Rujul-Rumale/OpenVCU/README.md

<div align="center">

# OpenVCU

### Open Vehicle Control Unit — one board, every vehicle.

**Quad · Plane · Rover · Boat — configurable STM32H7 controller for anything that moves.**






*Open hardware. Designed from scratch. Built to be flashed for whatever you bolt it to.*

</div>

---

## What is this?

OpenVCU is an **open-source vehicle control unit** built around the **STM32H743VIT6** (480&nbsp;MHz Cortex-M7, 2&nbsp;MB flash, 1&nbsp;MB RAM).

Off-the-shelf F4 flight controllers run out of headroom when you fuse RTK GPS + IMU at high rates for EKF-heavy work like 3D photogrammetry surveys. OpenVCU is my answer: H7-class compute, a clean sensor set, and one PCB that can be configured as a **quad, fixed-wing, rover, or boat** controller.

> ⚠️ **WIP — schematic in progress.** The schematic is done and under review; **layout hasn't started** and nothing has been manufactured. Firmware lives out-of-tree for now and is intentionally **not in this repo**.

---

## One board, four vehicles

| Vehicle | What OpenVCU gives you |
| :--- | :--- |
| 🚁 **Quad** | 4× PWM motor outputs (TIM1), 6-axis IMU + baro, SD logging |
| ✈️ **Plane** | PWM for elevon / tail / throttle + UART GPS + I2C compass header |
| 🚗 **Rover** | PWM for steering + throttle, battery sensing, FRAM for params |
| 🚤 **Boat** | Same as rover + sealed-box-friendly USB-C + SD blackbox |

All vehicle personalities share the same core: **IMU → EKF → PWM + telemetry + log**. The difference is just configuration and wiring.

---

## Hardware at a glance

| Block | Part | Notes |
| :--- | :--- | :--- |
| MCU | **STM32H743VIT6** | 480&nbsp;MHz M7, LQFP-100, 8&nbsp;MHz HSE + 32.768&nbsp;kHz LSE |
| IMU | **ICM-42688-P** | 6-axis, SPI, 32&nbsp;kHz ODR |
| Baro | **DPS310** | I2C `0x76`, interrupt pin routed |
| Logging | **FM25V02A** FRAM 256&nbsp;KB (SPI) + **microSD** over SDMMC1 4-bit | Params + blackbox |
| Power | LiPo → **MP1584EN** buck (5&nbsp;V) → **AP2112K** 3.3&nbsp;V LDO | Fused + reverse-protected input |
| USB | **USB-C** + USBLC6-2SC6 ESD | 5.1&nbsp;kΩ CC pull-downs |
| Compass | External via I2C header | For real heading on rovers / boats / planes |

---

## Interfaces

### PWM motor / servo outputs

| Output | MCU pin | Timer |
| :--- | :--- | :--- |
| OUT 1 | PE9 | TIM1_CH1 |
| OUT 2 | PE11 | TIM1_CH2 |
| OUT 3 | PE13 | TIM1_CH3 |
| OUT 4 | PE14 | TIM1_CH4 |

Quads take all four. Planes / rovers / boats just remap them (e.g. steering + throttle).

### Comms & storage

| Bus | Use |
| :--- | :--- |
| UART1 / UART3 / UART6 | GPS, telemetry radio, RC |
| I2C1 / I2C2 | Onboard DPS310 + external compass |
| SPI1 | ICM-42688-P |
| SPI2 / SPI3 | Expansion + FM25V02A FRAM |
| SDMMC1 | microSD 4-bit |
| USB OTG_FS | USB-C (PA11/PA12) |

### SWD debug header

| Pin | Signal |
| :--- | :--- |
| 1 | +3V3 |
| 2 | SWDIO (PA13) |
| 3 | SWCLK (PA14) |
| 4 | GND |

Flash with ST-Link + STM32CubeProgrammer once firmware lands.

---

## Repo structure

```
OpenVCU/
├── PCB/          # KiCad 10 — schematics + project libs (layout stays local)
│   ├── OpenVCU.kicad_sch      # root sheet
│   ├── Power.kicad_sch
│   ├── Sensors.kicad_sch
│   ├── Peripherals.kicad_sch
│   ├── OpenVCU.kicad_sym      # project symbols
│   └── OpenVCU.pretty/        # project footprints
├── bom/          # BOM CSV + interactive BOM
├── docs/
│   └── datasheets/            # vendor datasheets for every key part
├── LICENSE          # CERN-OHL-S-2.0 — hardware (PCB/, bom/)
├── LICENSE-MIT      # MIT — docs/, everything else
├── CONTRIBUTING.md
└── README.md
```

> Only schematics + libraries live in git. Layout (`.kicad_pcb`), gerbers, and firmware are **deliberately excluded** for now — layout is still WIP, firmware lands as `Firmware/` once the board is validated.

---

## Status & roadmap

- ✅ Schematic complete (hierarchical: Power / Sensors / Peripherals)
- ✅ BOM + interactive BOM exported
- 🚧 **Layout in progress** — not in git yet, no gerbers, nothing ordered
- ⏳ **Finish layout → DRC → manufacture rev A**
- ⏳ Bring-up: power rails → SWD → IMU/baro probe → SD + FRAM
- ⏳ Firmware bring-up (out-of-tree until hardware is proven)
- ⏳ Vehicle configs: quad → plane → rover → boat

---

## Getting started

### 1. Open the hardware

```bash
git clone https://github.com/<you>/OpenVCU.git
cd OpenVCU
# open PCB/OpenVCU.kicad_pro in KiCad 10
```

You need **KiCad 10** (project symbols live in `OpenVCU.kicad_sym`, footprints in `OpenVCU.pretty/`).

### 2. Review the BOM

- `bom/bom.csv` — orderable line items
- `bom/ibom.html` — interactive BOM, open in a browser

### 3. Layout / manufacturing

Layout is still WIP and lives only locally — there are no gerbers in this repo yet. Once the layout lands, re-export gerbers from the layout before ordering.

---

## Design notes

- **VCAP1/VCAP2 need exactly 2.2&nbsp;µF ceramic** or the H7 internal LDO goes unstable.
- **USB-C CC pins need 5.1&nbsp;kΩ to GND** or chargers won't enumerate the board.
- Planned stackup: 4-layer with GND pour; crystal section gets an isolated GND island.

---

## Contributing

WIP hardware — reviews welcome, especially on power, crystal, and sensor routing. See [CONTRIBUTING.md](CONTRIBUTING.md).

---

## ⚠️ Caution

Nothing here has touched real copper yet. Double-check every pin against the schematic before you fab or flash, and expect rev-A debugging.

---

## License

- **Hardware** (`PCB/`, `bom/`) — [CERN-OHL-S-2.0](LICENSE). If you make or sell boards from this design or a modified version, share your modified design files under the same license.
- **Docs, everything else** — [MIT](LICENSE-MIT).

---

## Credits

- Designed by **Rujul**
- [KiCad](https://www.kicad.org/) for schematic design
- Datasheets in `docs/datasheets/` belong to their respective vendors
