Rujul-Rumale/OpenVCU/PCB/OpenVCU.kicad_pcb

## KiCad design PCB/OpenVCU.kicad_pcb (2026-10-03)

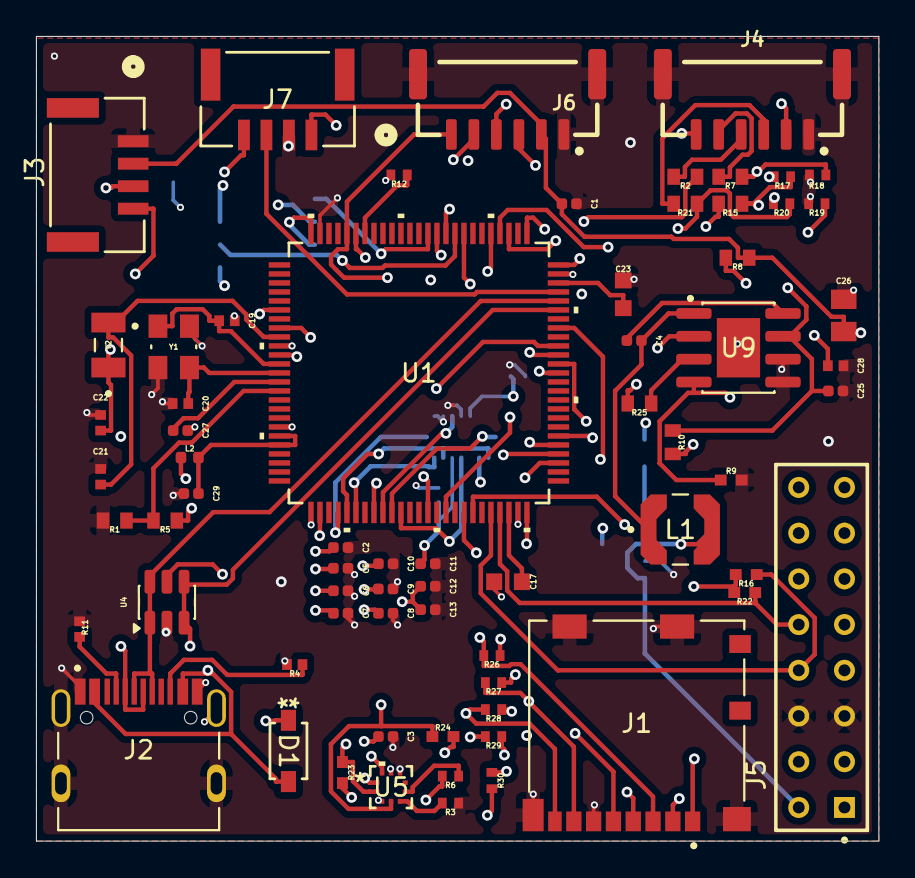
[picture p1: board OpenVCU.kicad_pcb from above]

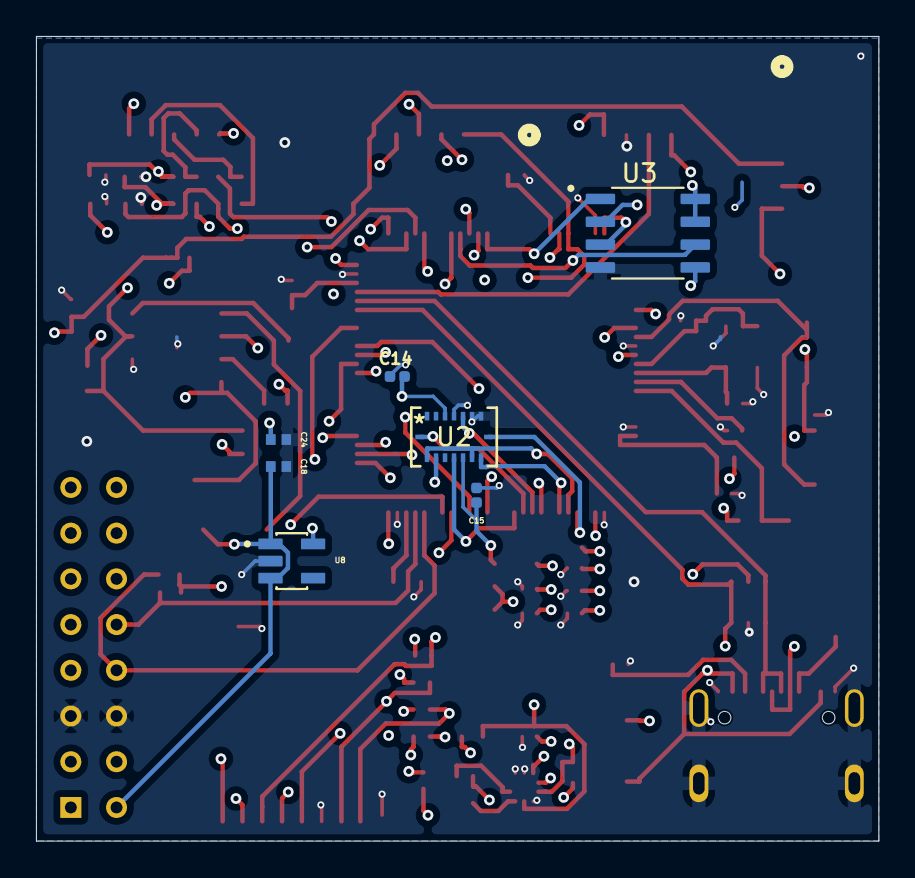
[picture p2: board OpenVCU.kicad_pcb from below]

Board: 4 copper layers, 46.8 x 44.7 mm, 75 parts (7 on the bottom side), 64 nets.

Parts:
C1, C2, C3, C4, C5, C6, C7, C8, C9, C10, C11, C12, C13, C14, C15, C25, C27, C29: C0402C104K3RACTU; CAPC1005X55N
C17, C23: GRM188R61C225KE15D; CAPC1608X90N
C18, C24: GRM155R61E105KA12D; CAPC1005X55N
C19, C20: GRM1555C1H180JA01D; CAPC1005X55N
C21, C22: GRM1555C1H7R0DA01D; CAPC1005X55N
C26: GRM21BR61A226ME51L; CAPC2012X140N
C28: GRM1555C1H222JA01D; CAPC1005X55N
D1: D_Schottky; SDO_SOD-123_MCC
J1: 104031-0811; MOLEX_104031-0811
J2: USB-C; HRO_TYPE-C-31-M-12
J3, J7: BM04B-GHS-TBT; CONN_BM04B-GHS-TBT_JST
J4, J6: BM06B-GHS-TBT
J5: BDL-108-X-X; SAMTEC_BDL-108-X-X
L1: LPS4018-103; IND_LPS4018-103
L2: L_Ferrite; L_0402_1005Metric
R1, R5, R8, R10, R25: RC0402FR-07100KL; RESC1005X40
R2, R7, R15, R21: RC0402FR-07100RL; RESC1005X40
R3, R6, R12, R17, R18, R19, R20, R26, R27, R28, R29, R30: RC0402FR-0710KL; RESC1005X40N
R4, R11: RC0402FR-075K1L; RESC1005X40N
R9: RC0402FR-0720KL; RESC1005X40N
R16, R22, R23, R24: RC0402FR-072K2L; RESC1005X40N
U1: STM32H743VIT6; LQFP100-14x14mm
U2: BMI088; QFN_BMI085_BOS
U3: FM25V02A-GTR; SOIC127P602X172-8N
U4: USBLC6-2SC6; SOT-23-6
U5: BMP390; 10LGA_2X2X0p75_BOS
U8: AP2112K-3.3TRG1; SOT95P285X140-5N
U9: MP1584EN; SOIC127P600X170-9N
Y1: ABM8-272-T3; XTAL_ABM8-272-T3
Y2: CM315D32768DZFT; XTAL_CM315D32768DZFT

Connections:
+3V3: C2.1, C3.1, C5.1, C6.1, C7.1, C8.1, C9.1, C10.1, C11.1, C12.1, C13.1, C14.2, C15.2, C24.1, J1.4 (VDD), J5.03, J5.04, J7.1, L2.1, R6.2, R16.2, R22.2, R23.2, R24.2, R26.1, R27.1, R28.1, R29.1, R30.1, U1.6 (VBAT), U1.11 (VDD), U1.27 (VDD), U1.50 (VDD), U1.75 (VDD), U1.100 (VDD), U2.3 (VDD), U2.11 (VDDIO), U3.3 (~WP), U3.7 (~HOLD), U3.8 (VDD), U5.1 (VDDIO), U5.10 (VDD), U8.5 (VOUT)
+5V: C1.1, C18.1, C26.1, D1.1 (K), J3.2, J5.01, J5.02, J6.2, L1.2, R8.1, U4.5 (VBUS), U8.1 (VIN), U8.3 (EN)
/BMI_INT1: U1.35 (PB1), U2.16 (INT1)
/BMI_INT3: U1.36 (PB2), U2.12 (INT3)
/Comp_resistor: R25.1, U9.3 (COMP)
/FLASH_CS: U1.87 (PD6), U3.1 (~CS)
/I2C1_SCL: J6.5, R23.1, U1.95 (PB8), U5.2 (SCK)
/I2C1_SDA: J6.6, R24.1, U1.96 (PB9), U5.4 (SDI)
/I2C2_SCL: J5.08, R16.1, U1.46 (PB10)
/I2C2_SDA: J5.10, R22.1, U1.47 (PB11)
/NRST: C27.1, U1.14 (NRST)
/PWM1: R20.1, R21.1, U1.39 (PE9)
/PWM2: R2.1, R19.1, U1.41 (PE11)
/PWM3: R7.1, R18.1, U1.43 (PE13)
/PWM4: R15.1, R17.1, U1.44 (PE14)
/SDMMC1_CLK: J1.5 (CLK), U1.80 (PC12)
/SDMMC1_CMD: J1.3 (CMD), R26.2, U1.83 (PD2)
/SDMMC1_D0: J1.7 (DAT0), R27.2, U1.65 (PC8)
/SDMMC1_D1: J1.8 (DAT1), R28.2, U1.66 (PC9)
/SDMMC1_D2: J1.1 (DAT2), R29.2, U1.78 (PC10)
/SDMMC1_D3: J1.2 (CD/DAT3), R30.2, U1.79 (PC11)
/SPI1_MISO: U1.30 (PA6), U2.10 (SDO2), U2.15 (SDO1)
/SPI1_MOSI: U1.31 (PA7), U2.9 (SDA/SDI)
/SPI1_SCK: U1.29 (PA5), U2.8 (SCL/SCK)
/SPI2_MISO: U1.85 (PD4), U3.2 (SO)
/SPI2_MOSI: U1.86 (PD5), U3.5 (SI)
/SPI2_SCK: U1.84 (PD3), U3.6 (SCK)
/SPI_CS_ACCEL: U1.33 (PC5), U2.14 (CSB1)
/SPI_CS_GYRO: U1.34 (PB0), U2.5 (CSB2)
/SWCLK: J7.4, U1.76 (PA14)
/SWDIO: J7.3, U1.72 (PA13)
/SW_NODE: C4.2, L1.1, U9.1 (SW)
/UART1_RX: J3.3, U1.54 (PB15)
/UART1_TX: J3.4, U1.53 (PB14)
/UART3_RX: J6.3, U1.56 (PD9)
/UART3_TX: J6.4, U1.55 (PD8)
/UART6_RX: J5.09, U1.64 (PC7)
/UART6_TX: J5.07, U1.63 (PC6)
/USB_D_N: J2.A7 (DN1), J2.B7 (DN2), U1.70 (PA11), U4.3 (I/O2), U4.4 (I/O2)
/USB_D_P: J2.A6 (DP1), J2.B6 (DP2), U1.71 (PA12), U4.1 (I/O1), U4.6 (I/O1)
/VBAT: C25.1, J4.2, R10.1, U9.7 (VIN)
/VBUS_DIV: R1.1, R5.2, U1.15 (PC0)
GND: C1.2, C2.2, C3.2, C5.2, C6.2, C7.2, C8.2, C9.2, C10.2, C11.2, C12.2, C13.2, C14.1, C15.1, C17.1, C18.2, C19.2, C20.1, C21.2, C22.2, C23.2, C24.2, C25.2, C26.2, C27.2, C28.2, C29.1, J1.6 (VSS), J1.G1 (GND), J1.G2 (GND), J1.G3 (GND), J1.G4 (GND), J2.A1B12 (GND), J2.B1A12 (GND), J2.S1 (SHIELD), J2.S2 (SHIELD), J2.S3 (SHIELD), J2.S4 (SHIELD), J3.1, J4.1, J4.13 (CHASSIS@1), J4.14 (CHASSIS@2), J5.05, J5.06, J6.1, J6.13 (CHASSIS@1), J6.14 (CHASSIS@2), J7.2, R1.2, R3.1, R4.2, R9.2, R11.1, R12.2, R17.2, R18.2, R19.2, R20.2, U1.10 (VSS), U1.19 (VSSA), U1.26 (VSS), U1.49 (VSS), U1.74 (VSS), U1.99 (VSS), U2.4 (GNDA), U2.6 (GNDIO), U2.7 (PS), U3.4 (VSS), U4.2 (GND), U5.3 (VSS), U5.8 (VSS), U5.9 (VSS), U8.2 (GND), U9.5 (GND), U9.6 (FREQ), U9.9 (GND), Y1.2 (GND), Y1.4 (GND)
unnamed: C28.1, R25.2
unnamed: J2.A5 (CC1), R11.2
unnamed: J2.B5 (CC2), R4.1
unnamed: J4.3, R21.2
unnamed: J4.4, R2.2
unnamed: J4.5, R7.2
unnamed: J4.6, R15.2
unnamed: R12.1, U1.94 (BOOT0)
unnamed: C22.1, U1.8 (PC14-OSC32_IN), Y2.1
unnamed: C21.1, U1.9 (PC15-OSC32_OUT), Y2.2
unnamed: C19.1, U1.12 (PH0-OSC_IN), Y1.1
unnamed: C20.2, U1.13 (PH1-OSC_OUT), Y1.3
unnamed: C17.2, U1.48 (VCAP1)
unnamed: C23.1, U1.73 (VCAP2)
unnamed: C29.2, L2.2, U1.20 (VREF+), U1.21 (VDDA)
unnamed: R6.1, U5.6 (CSB)
unnamed: R3.2, U5.5 (SDO)
unnamed: C4.1, U9.8 (BST)
unnamed: R10.2, U9.2 (EN)
unnamed: R8.2, R9.1, U9.4 (FB)
VBUS: D1.2 (A), J2.A4B9 (VBUS), J2.B4A9 (VBUS), R5.1, U1.68 (PA9)
