Rujul-Rumale/OpenVCU/(commit log)

2026-10-03 Initial commit: OpenVCU H7 vehicle control unit by Rujul
    - KiCad 10 schematic (root + Power/Sensors/Preipherals) and 4-layer PCB
    - ArduPilot hwdef.dat for OpenVCU-H7 (STM32H743VIT6) + prebuilt binaries
    - BOM + interactive BOM, JLCPCB/PCBway Gerbers
    - Rebranded from Falcon/H7-DroneFC to OpenVCU, made by Rujul
2026-10-03 Fix Peripherals filename typo (was Preipherals); KiCad ERC settings block
2026-10-04 Sensors rework: ICM-42688-P + DPS310 replace BMI088/BMP390
    - Full sensor-area rebuild per TDK DS-000347 + Infineon DPS310 datasheets
    - ICM-42688-P on SPI1 (PC4 CS pending hierarchy), INT1/INT2, 100nF+2.2uF on VDD, 10nF on VDDIO, RESV to GND
    - DPS310 on I2C1 (0x76 via SDO pull-down, INT capable), CSB to VDDIO, 100nF on VDD/VDDIO
    - Working 2.2k I2C pull-ups to 3V3; all shorts (VSS/VDDIO rails) removed
    - New project libs: OpenVCU.kicad_sym, OpenVCU.pretty (both footprints), sym/fp-lib-tables
    - ERC Sensors: 28 errors -> 3 expected pre-hierarchy (undriven SPI inputs)
    - BOM + README updated; datasheets archived under docs/
2026-10-04 Power sheet P2: USB-C fix, buck replacement, LDO rewire, battery sense, pull-downs
    - Replaced MP1584 buck with TPS54360 (EOL fix)
    - Fixed USB-C: CC pull-downs, ESD wiring, VBUS path, shell ground
    - Rewired LDO: VIN<-+5V, GND->GND, VOUT->+3V3, caps at pins
    - Added battery sense divider (100k/10k from VBAT)
    - Added SBU1/SBU2 1M pull-downs (R38, R39)
    - Fixed component rotations for distinct pin tips (90°)
    - Added PWR_FLAGS on +5V rail (source) and VBUS net
    - Added SBU1/SBU2 1M pull-downs (R38, R39)
    - Removed old MP1584 debris
2026-10-04 Hierarchy: Power sheet hierarchical labels + root sheet pins (via Konnect)
    - Added 5 hierarchical labels to Power.kicad_sch (VBAT, USB_D_P, USB_D_N, VBUS_SENSE, VBUS_DIV)
    - Imported matching sheet pins onto root Power instance
    - validate_sheet_pins: 0 issues; both files parse cleanly
    - Root cause of A1: sub-sheets had only local labels, zero hierarchical labels
2026-10-04 Hierarchy: Sensors sheet hierarchical labels + root sheet pins (via Konnect)
    - Added 8 hierarchical labels to Sensors.kicad_sch
    - Fixed net-name mismatch: IMU_CS->SPI_CS_ACCEL, IMU_INT1->BMI_INT1 (match root MCU labels)
    - Imported matching sheet pins on root Sensors instance
    - validate_sheet_pins: 0 issues
2026-10-04 Hierarchy: Peripherals sheet hierarchical labels + sheet pins (via Konnect)
    - Added 27 hierarchical labels to Peripherals.kicad_sch
    - Skipped dead leftover nets (L1_cap1, PWMx_R)
    - Resized Peripherals sheet to 60x90mm to fit 27 pins on one edge
    - Imported matching sheet pins on root Peripherals instance
    - validate_sheet_pins: 0 issues across all three sheets
    - Full hierarchy now valid: Power + Sensors + Peripherals all cross-linked
2026-10-04 Hierarchy: connect root sheet pins to MCU nets (via Konnect)
    - Added 37 root net labels at the imported sheet-pin positions
    - Sensors now 0 ERC violations; root total 356 -> 253
    - isolated_pin_label 76 -> 5 (only stray/leftover nets remain)
    - Remaining: VBAT/BARO_INT root nets, SPI_CS_GYRO/BMI_INT3 (IMU2 pins not yet on Sensors sheet)
2026-10-04 Library: FPV-style castellated pad-row connectors (via Konnect)
    - Footprints: PADROW-2/4/5/6 (1xN) + HEADER-2x6, 2.54mm pitch, 1.7x2.5mm THT pads, 1.0mm drill
    - Symbols: CONN-2/4/5/6 + CONN-2x6 (passive pins) in OpenVCU.kicad_sym
    - Ready to replace JST-GH/Samtec on Peripherals sheet
2026-10-04 Peripherals: replace JST-GH/Samtec with castellated pad-row connectors
    - Deleted J3/J4/J5/J6/J7 (JST-GH + Samtec)
    - Added J3 GPS(PADROW-6), J4 TELEM(PADROW-5), J5 I2C2(PADROW-4),
    J6 SPI2(PADROW-6), J7 SWD(PADROW-5), J8 GPIO-EXP(HEADER-2x6),
    J9 MOTOR(PADROW-4), J10 BUZZ(PADROW-2), J11 LED(PADROW-2)
    - Connected all pads to nets via Konnect connect_to_net
    - NOTE: PWM series-resistor network (R2/R7/R15/R21) now orphaned, needs rebuild
    - New nets needing root connection: GPIO_A0..A7, BUZZ, LED, NRST
2026-10-04 Root cleanup: no_connect markers + VBAT/BARO_INT root nets + stale PWR_FLAG cleanup
    - Added 42 no_connect markers to intentionally floating MCU pins
    - Removed 3 stale PWR_FLAGS from root (SPI_CS_GYRO, BMI_INT3, SW)
    - Added VBAT and BARO_INT hierarchical labels to root
    - Added PWR_FLAGS on +5V rail source and VBUS net
    - Hierarchy fully valid (validate_sheet_pins: 0 issues)
    - Remaining ERC: root floating pins + power sheet residue + peripheral PWM block
2026-10-05 Root: drop 4 dangling hierarchical labels, add root-side labels for VBAT/BARO_INT sheet pins
    The root sheet had 4 hierarchical labels floating in empty space (no wire,
    no pin) - invalid on a root sheet since there is no parent to bind them to.
    Removed them. Added plain labels at the exact sheet-pin coordinates for the
    3 sheet pins that had no root-side net: Power VBAT, Peripherals VBAT,
    Sensors BARO_INT. Sheet pins were already present and correct (KiCad 9
    writes them as (pin "NAME" shape ...) inside the sheet block).
    ERC 304 -> 300 violations.
2026-10-05 gitignore local kicad-cli ERC reports
2026-10-05 Root: delete orphan PWR_FLAG legend block, 21 stray no_connect markers
    The three PWR_FLAGs (#FLG01-03) sat stacked on three power symbols
    (#PWR094-096) at y=191.77 in empty space, isolated from the circuit.
    KiCad resolved them into the net containing U1 pin 43 (PE13/PWM3) and
    U1 pin 68 (PA9/VBUS_SENSE), which put a power-output pin on those nets
    and produced 2 bogus pin_to_pin errors.
    Also removed 21 no_connect markers that floated in empty space below
    the MCU (y=160..279), including one duplicated marker at (138.43,71.12).
2026-10-05 Peripherals+root: SWD header, GPIO expansion, PWM output stage, LED/BUZZ/BARO_INT
    Peripherals (PCB/Peripherals.kicad_sch):
    - J7 (CONN-5) is a proper SWD header: +3V3 / SWDIO / SWCLK / NRST / GND,
    first three exported as hierarchical labels matching the existing root sheet pins.
    - J8 (CONN-2x6) expansion header: +3V3, +5V, GND, GND, GPIO_A0..GPIO_A7.
    GPIO_A0..A7 are hierarchical labels on new left-edge sheet pins.
    - PWM output stage PWMn -> 100R (R21/R2/R7/R15) -> PWMn_R -> J9 (motor header),
    with the existing 10k R20/R19/R18/R17 as pull-downs on PWMn_R.
    - J10 BUZZ and J11 LED exported as hierarchical labels; J4.5 spare TELEM pad -> GND.
    - Removed 6 duplicate wires, 4 dead SWDIO/SWCLK l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
2026-10-05 Root: rotate the 11 left-edge Peripherals sheet pins to 180
    KiCad resolves a sheet pin's connection point from its rotation: pins on a sheet's
    left edge must use rotation 180. With rotation 0 the 11 new GPIO_A0..A7/BUZZ/LED/NRST
    pins were not connection points, so the matching root labels were reported dangling and
    the nets never merged with the Peripherals sheet.
    Verified in the exported netlist: /GPIO_A0={J8.5,U1.1}, /GPIO_A7={J8.12,U1.28},
    /BUZZ={J10.1,U1.90}, /LED={J11.1,U1.34}, /SWDIO={J7.2,U1.72}, /SWCLK={J7.3,U1.76}.
    ERC: 249 -> 240 (label_dangling 11 -> 0).
2026-10-05 Power+root: drive every ERC error to zero
    Power sheet
    - add power:PWR_FLAG to the lib_symbols cache under its full lib_id so the
    flags actually resolve to a pin (a bare "PWR_FLAG" cache key resolves to
    zero pins and silently disables the flag)
    - one PWR_FLAG per net: +5V, FB divider node, VBUS_SENSE
    - name the TPS54360 divider node FB so R53/R54/R55 join U9.5's net
    - wire U9.8 (SW) to the existing SW label (buck half-bridge)
    - drop 12 orphan power symbols, the duplicate D_Schottky ref, R9/C28 and
    14 junk wires; re-point the USB-C CC pull-downs at Device:R
    - rebuild the FB/COMP network to the standard TPS54360 divider
    - label the USBLC6 pass-through pins USB_D_P/USB_D_N/VBUS_SENSE
    Root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
2026-10-05 Power: fix the shorted buck input rail (VBAT)
    The buck input network was silently shorted to GND and had no VBAT net at all:
    * L1.1 (inductor, SW side) was wired to the +5V node instead of SW, shorting
    SW to +5V through the inductor
    * C51.2's GND stub passed straight through R50.1's pin, dragging the TPS54360
    feedback/EN divider top and VIN down to GND
    Rebuild the VBAT tap and the +5V output node so that
    /Power/VBAT = C51.1, C52.1, C53.1, R50.1, U9.2 (VIN)
    /Power/SW = C50.2, D1.1, L1.1, U9.8 (catch diode + inductor)
    +5V = C55.1, C56.1, L1.2, R53.1, ...
    Also drop the vestigial VBAT hierarchical pin (Power + Peripherals) and its two
    root labels: nothing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
2026-10-05 Power: add battery input stage (J12, F1, D2)
    2S-4S Li-ion (7.4-16.8 V) feed for the TPS54360 buck:
    J12 OpenVCU:PADROW-2 battery connector (+/-)
    F1 Device:Fuse / 5A fuse, 1206
    D2 Device:D_TVS / SMBJ18A bidirectional TVS to GND, SMB
    C51-C53 3x 10uF/50V bulk on the VBAT rail
    Net /Power/VBAT = J12(via F1), D2, C51/C52/C53, R50 divider, U9 VIN.
    Also fix libsync's project-library parser (the project .kicad_sym stores
    symbols at a different indentation) and normalise inserted cache entries to
    carry the full lib_id as the key.
    ERC: 0 errors.
2026-10-05 Power/root: fix USB VBUS sensing and remove ambiguous net names
    * U1.68 (PA9) was wired straight to raw VBUS, so the MCU saw up to 20V
    instead of the divided voltage. It is now on VBUS_DIV, whose only other
    members are the R1/R5 divider tap and U1.15 (PC0)
    * the divider's top node is labelled VBUS, matching the USB-C VBUS pins and
    the USBLC6 VBUS pin, so there is no VBUS/VBUS_SENSE clash
    * drop the now-unused VBUS_SENSE hierarchical pin and its root label
    ERC: 0 errors, 201 -> 190 warnings.
2026-10-05 Peripherals: break out UART6, clear stub wires, tie C26 to +3V3
    * add J13 (PADROW-5): UART6_TX / UART6_RX / GND x3, so the two UART6 sheet
    pins now terminate on a real connector instead of dangling mid-sheet
    * delete nine zero-length / dangling wire stubs left over from earlier edits
    * delete #PWR078/#PWR079 (duplicate +3V3 symbols stranded by the stub cleanup)
    * C26 pin1 was labelled L1_cap1 with nothing on the other side; tie it to +3V3
    ERC: 0 errors, 201 -> 173 warnings.
2026-10-05 Power/root: snap the VCAP1 flag and the COMP_C network onto the grid
    * #FLG0104 (VCAP1 PWR_FLAG) sat at y=155.24; move it to 153.67 and shorten
    its stub
    * R55.2 -> COMP_C and C54 -> GND were routed at x=83.82 / 87.96, which is off
    the 1.27mm grid the rest of the sheet uses; redraw them at x=83.82 (shorter
    stub) and 87.63
    endpoint_off_grid: 71 -> 64 (remaining 64 are all on the Sensors sheet).
    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
2026-10-05 Sensors: put the sheet on the 1.27mm grid (project symbols only)
    OpenVCU:ICM-42688-P and OpenVCU:DPS310 (the project's own symbols) had side
    pins anchored at -8/-5.46/-2.92/-0.38 and -5/-2.46/0.08/2.62. No pin was ever
    a 1.27mm multiple, and because the pitches were 2.54 the error accumulated down
    the side, so *no* instance translation could ever align them - every pin and
    every wire on the sheet was permanently off-grid.
    Only those two symbol definitions are changed: their pins now sit on a 2.54
    pitch anchored on-grid, with the GND/RESV groups stacked onto one connection
    point per device. PCB/OpenVCU.kicad_sym is updated to match, and the sheet is
    re-laid out on the grid.
    Netlist is pre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
2026-10-05 Sensors: document the DPS310 SDO pin's dual role
    Checked against the DPS310 datasheet (Table 2, section 4.6). In I2C mode pin 5
    is *both* the interrupt output and the I2C address LSB:
    "The sensor uses the SDO pin for the interrupt signal ... In I2C
    configuration the SDO pin serves as both interrupt and as the least
    significant bit in the device address. If the SDO pin is pulled low the
    interrupt polarity must be set to active high and vice-versa."
    So BARO_INT belongs on pin 5 - that is the only interrupt path the DPS310 has.
    R31 (100k to GND) straps the address to 0x76 and forces active-high IRQ, which
    matches the README. No rewire needed; rename the pin to "SDO/INT" so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
2026-10-05 docs: add vendor datasheets for all schematic parts
    Added 17 datasheets covering all active BOM parts:
    Core MCU & Power:
    - STM32H743VI-datasheet.pdf (1.5 MB, Octopart/LSCS mirror)
    - TPS54360-datasheet.pdf (2.5 MB, TI direct)
    - AP2112K-datasheet.pdf (755 KB, Diodes Inc)
    - USBLC6-2SC6-datasheet.pdf (22 MB, LCSC mirror)
    Sensors:
    - DPS310-datasheet.pdf (829 KB, existing)
    - ds-000347-icm-42688-p-v1.6.pdf (1.8 MB, existing)
    FRAM:
    - FM25V02A_Farnell.pdf (597 KB, Farnell)
    - FM25V02A_RS.pdf (1.5 MB, RS-Online)
    - FM25V02A_Avaq.pdf (59 KB, Avaq mirror)
    Schottky diode (D1, D2):
    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
2026-10-05 Power: add VBAT_IN label on battery input net
    Label the battery-side net of the fuse F1 as "VBAT_IN" for clarity
    instead of the auto-generated "Net-(J12-P1)". No functional change.
    ERC: 0 errors, 91 warnings (unchanged).
2026-10-07 ICM-42688-P: fix pin overlap in project library symbol
    Pin 2,3,6,7 (left side) and 10,11 (right side) were stacked at identical
    coordinates. Re-spaced all 14 pins at 2.54 mm pitch per datasheet.
    Left side (x=-10.16, rot=0): SDO, GND, GND, INT1, VDDIO, GND, GND
    Right side (x=10.16, rot=180): VDD, INT2, GND, GND, CS, SCLK, SDI
    ERC: 0 errors (92 vendor warnings). overlap.py/junctions.py: 0 issues.
2026-10-07 Add schematic verification tools (overlap, junctions, libsync, edit)
2026-10-11 Repo scope: schematics + libs only
    - Drop layout (.kicad_pcb), gerbers, tools/ from git (kept locally)
    - README/CONTRIBUTING: layout is WIP, no manufacturing claims
